chinmay09/ECEN_5009_Project_Lab/Patil_Schematic_20181208/Patil_Schematic01_20181208.pdf

# Revision History

REV ZONE | DESCRIPTION | DRFT | DATE | PCO/ECO

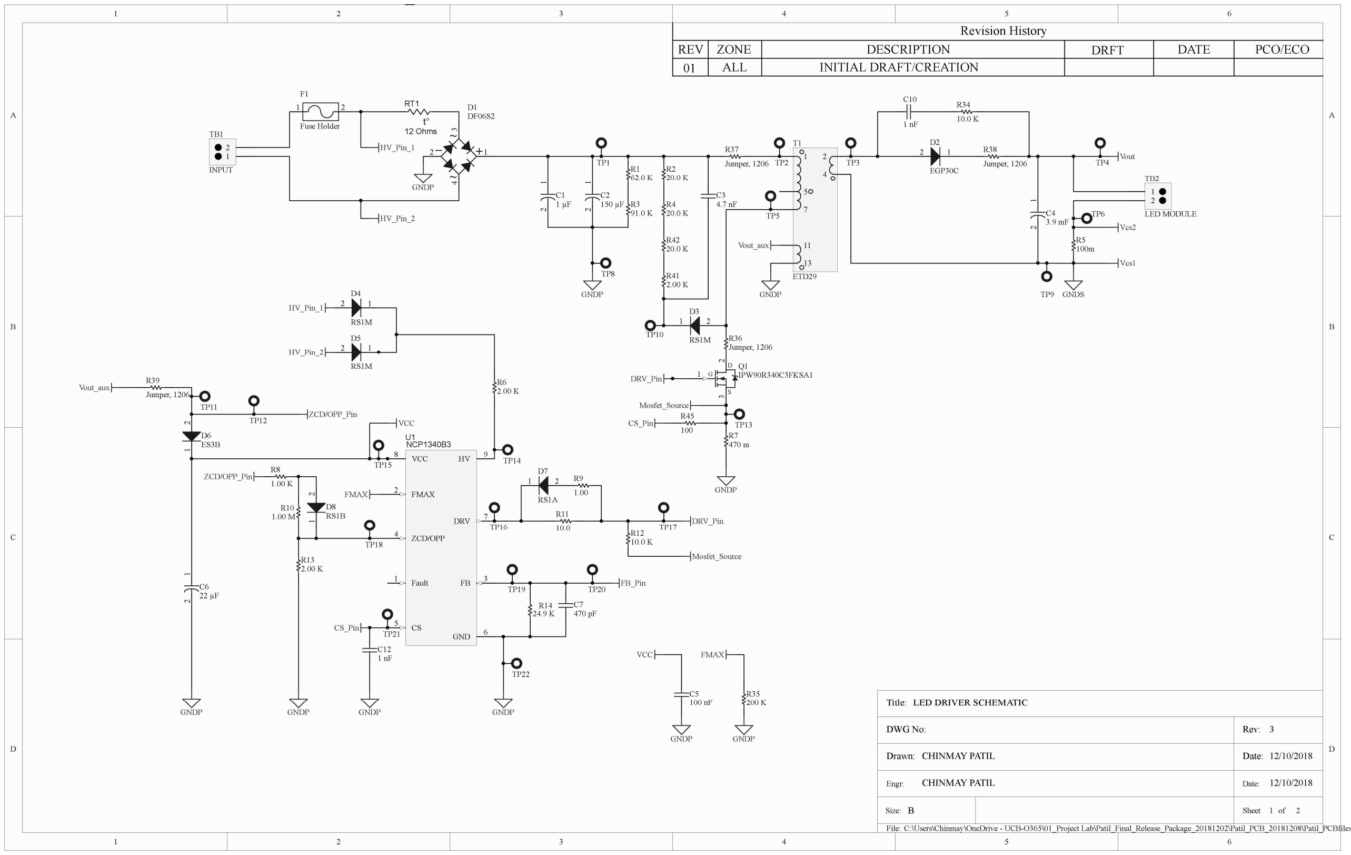
[picture p1: page 1]

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
## LED DRIVER SCHEMATIC

3

12/10/2018

C:\Users\Chinmay\OneDrive - UCB-O365\01_Project Lab\Patil_Final_Release_Package_20181202\Patil_PCB_20181208\Patil_PCBfiles_20181208\Patil_Sheet_1_20181208.SchDoc

## Title:

Size:

## DWG No:

## Date:

File:

## Rev:

B | Sheet | of

## Drawn:

Engr: | Date:
01 | ALL | INITIAL DRAFT/CREATION

## CHINMAY PATIL

CHINMAY PATIL | 12/10/2018

1

2

TB1

INPUT

1 2

F1

Fuse Holder | 3

1 4

2 +

_

~

~

D1
DF06S2

GNDP

C3

### 4.7 nF

GNDP

GNDP

2 1

D2

EGP30C

1
2

TB2

LED MODULE

Fault 1

FMAX 2

FB 3

ZCD/OPP 4

CS 5
GND | 6
DRV | 7
VCC 8 | HV | 9

U1
NCP1340B3

2 1

D5

RS1M

2 1

D4

RS1M

GNDP 1 2 D6

# ES3B 1 2

C6

### 22 µF

GNDP | GNDP | GNDP

R8

### 1.00 K

R13

### 2.00 K

1 2

D7

RS1A

R9
1.00

R11

### 10.0 R12

### 10.0 K

GNDS

R6

### 2.00 K

1 2
C1

### 1 µF

1 2

D3

RS1M

1 2
C2
150 µF

R1

### 62.0 K

R3

### 91.0 K

C5
100 nF

GNDP ¹ ² D8

RS1B

C10

### 1 nF

R34

### 10.0 K

GNDP

t°

RT1

### 12 Ohms

R7
470 m

R5

100m ¹ ²
C4

### 3.9 mF

R36
Jumper, 1206

R37
Jumper, 1206

R38
Jumper, 1206

R39

Jumper, 1206 | S D

G 2 3
1

Q1
IPW90R340C3FKSA1

R41

### 2.00 K

R2

### 20.0 K

R4

### 20.0 K

R42

### 20.0 K

1 2

4

5

7

11

13

T1

ETD29

Vout_aux

Vout_aux

ZCD/OPP_Pin

ZCD/OPP_Pin

VCC

VCC

FMAX

FMAX

CS_Pin

CS_Pin

Mosfet_Source

Mosfet_Source

DRV_Pin

DRV_Pin

FB_Pin

Vout

Vcs2

Vcs1

HV_Pin_1

HV_Pin_1

HV_Pin_2

HV_Pin_2

TP1 | TP2

TP5

TP10

TP8

TP3

TP14 TP15

TP12

TP11

TP18

TP16 | TP17
TP19 | TP20

TP22

TP21

TP13

TP6

TP4

TP9

R10

### 1.00 M

C7
470 pF

R14

### 24.9 K

R35
200 K
GNDP

R45
100

C12

### 1 nF
