chinmay09/ECEN_5009_Project_Lab/Patil_Schematic_20181208/Patil_Schematic02_20181208.pdf

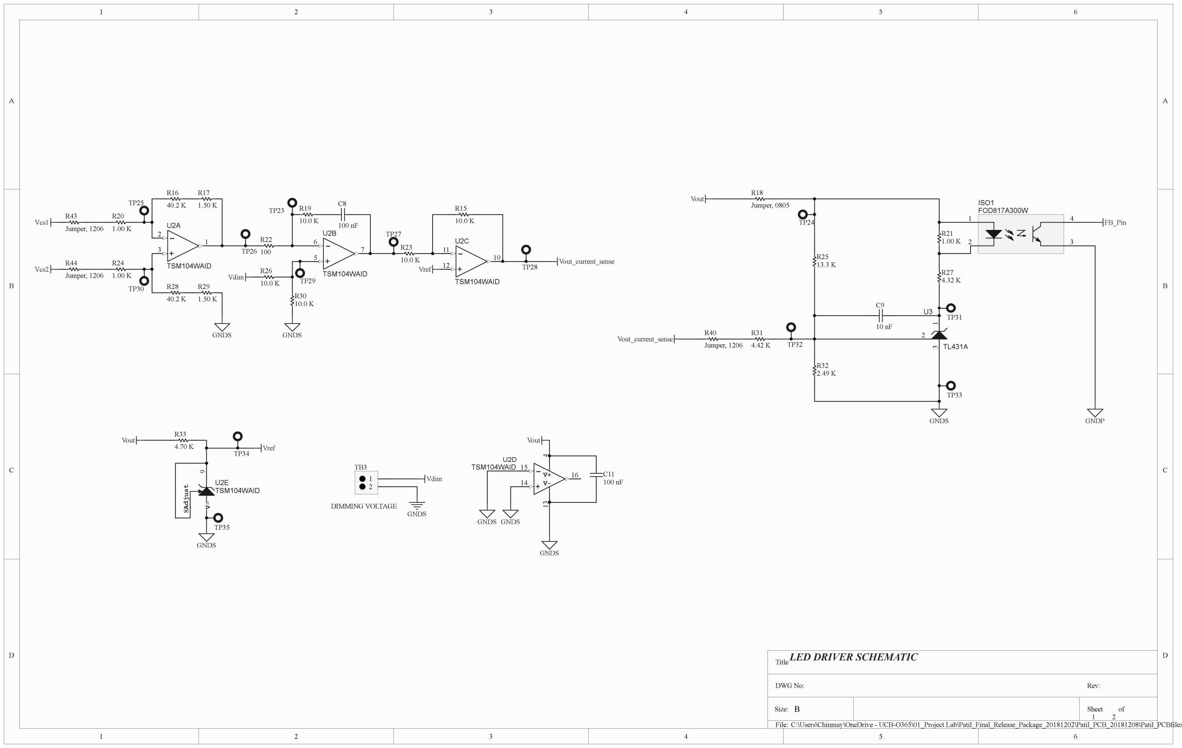
[picture p2: page 1]

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
## LED DRIVER SCHEMATIC

C:\Users\Chinmay\OneDrive - UCB-O365\01_Project Lab\Patil_Final_Release_Package_20181202\Patil_PCB_20181208\Patil_PCBfiles_20181208\Patil_Sheet_2_20181208.SchDoc

Title

Size:

DWG No:

File:

Rev:

B | Sheet | of

R24

### 1.00 K

R20

### 1.00 K

R16

### 40.2 K

R28

### 40.2 K

R17

### 1.50 K

R29

### 1.50 K

GNDS

R19

### 10.0 K

R26

### 10.0 K

R30

### 10.0 K

GNDS

GNDS

GNDS

2

1 4

3

ISO1
FOD817A300W

GNDP

1
2

TB3

DIMMING VOLTAGE

GNDS ⁹

8Adjust V-

U2E
TSM104WAID

GNDS

2 3 1

U3

TL431A

R23

### 10.0 K

R15

### 10.0 K

R33

### 4.70 K

GNDS GNDS

R18
Jumper, 0805

R32

### 2.49 K

14

15

16 13 4 +
- V+
V-

U2D
TSM104WAID

12

11
10
+

U2C

TSM104WAID

5

6
7
+

U2B

TSM104WAID

3

2
1
+

U2A

TSM104WAID

C11
100 nF

R40
Jumper, 1206

R43
Jumper, 1206

R44
Jumper, 1206

Vcs1

Vcs2
Vdim

Vref

Vout_current_sense

Vout_current_sense

Vout

FB_Pin

Vout | Vout

Vdim

Vref

TP28

TP27

TP23

TP26

TP29

TP25

TP30

TP34

TP35

TP24

TP31

TP32

TP33

R22
100

C8

100 nF
R21

### 1.00 K

R27

### 4.32 K

C9

### 10 nF

R25

### 13.3 K

R31

### 4.42 K
