chinmay09/ECEN_5009_Project_Lab/Patil_Calculations_20181208/Patil_Calculations_20181208-DESKTOP-5JLHRRT.pdf

# ECEN 5009 Power Electronics Project Lab

Prepared By: | CHINMAY PATIL
Project: | LED Driver
Last Updated: | 8-Dec-2018
Description: | PROJECT CALCULATIONS
Revision: | 4

## General Calculations

## Vac

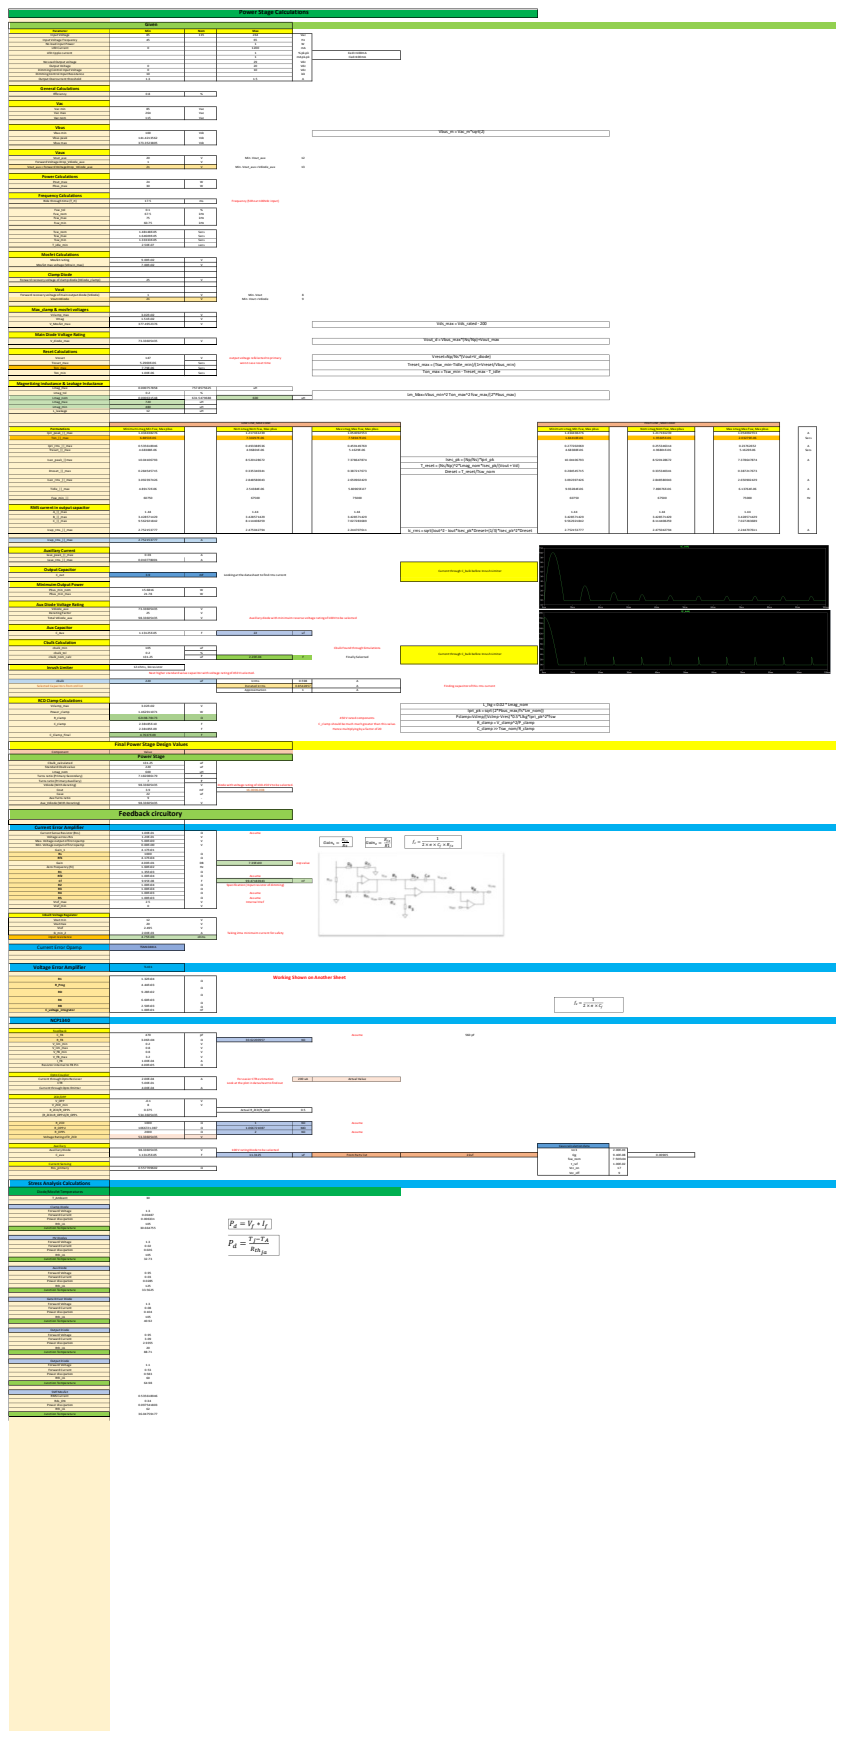
[picture p3: page 2]
Parameter; Min; Nom; Max; Input Voltage; Vac; Input Voltage Frequency; No load input Power; LED Current; LED ripple current; Iled>=100mA; Iled<100mA; No Load Output voltage; Vdc; Output Voltage; Dimming Control Input Voltage; Dimming Control Input Resistance; Output Overcurrent threshold; Efficiency; Vac min; Vac max; Vac nom; Vbus; Vbus min; Vbus peak; Vbus max; Vaux; Vout_aux; Min. Vout_aux; Forward Voltage Drop_Vdiode_aux; Vout_aux + Forward VoltageDrop_ Vdiode_aux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

Power Stage Calculations

V_Mosfet_max 377.4952376 | V

Main Diode Voltage Rating

Vreset=Np/Ns*(Vout+V_diode)

Magnetizing inductance & Leakage Inductance

T_reset = (Ns/Np)^2*Lmag_nom*Isec_pk/(Vout + Vd)

RMS current in output capacitor

Minimuim Output Power

Aux Diode Voltage Rating

Current through C_bulk before Inrush Limiter

Next higher standard value capacitor with voltage rating of 450 V selected.

RCD Clamp Calculations

Vclamp_max Power_clamp | 3.02E+02 1.462911071 | V W

Pclamp=Vclmp/(Vclmp-Vres)*0.5*Llkg*Ipri_pk^2*fsw

Final Power Stage Design Values

Current Error Amplifier

Inbuilt Voltage Regulator

Working Shown on Another Sheet

Voltage Rating of D_ZCD | 53.33605435 | V

Stress Analysis Calculations
Diode/Mosfet Temperatures

Gate Driver Diode

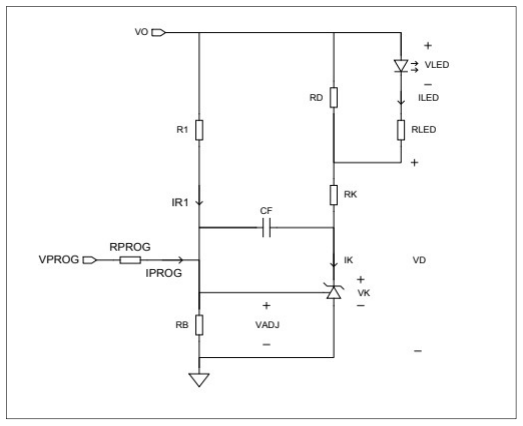
[picture p4: figure]

Vout_min | 10 | V
Vout_max | 21 | V
Vadj | 2.495 | V
I_BIAS | 1.00E-03 | A
Vprog_min | 0.7 | V
Vprog_max | 4.406 | V
Vk | 2.5 | V
V_diode_opto | 0.9 | V
V_acrossRK | 6.6 | V
Ik_min | 1.00E-03 | A
Ie_min | 1.00E-03 | A
I_opto_min | 3.00E-05 | A
I_opto_max | 4.00E-04 | A
Id_min | 6.00E-04 | A
Id_max | 9.70E-04 | A
A11 | 7.505 | V
A12 | 1.911 | V
A21 | 18.505 | V
A22 | -1.795 | V
A | 7.505 | 1.911
18.505 -1.795
A^-1 | 0.03675678 0.039132
0.37893269 -0.15368
I_BIAS | 1.00E-03
| 1.00E-03
G1 | = | A^-1 | X | I_BIAS
G1 | 7.5889E-05 | GPROG | I_BIAS
GPROG | 2.25E-04
R1 | 1.32E+04 | Ω
RPROG | 4.44E+03 | Ω
RD | 9.28E+02 | Ω
RK | 6.60E+03 | Ω
RB | 2.50E+03 | Ω
Cf | 10 | nF | Fz | 166 | Hz

# TL431 Calculations

# Fz = 1/(2∏Cf)

# A11 = Vout_min - Vadj A12 = Vprog_max - Vadj A21 = Vout_max - Vadj A22 = Vprog_min - Vadj

# Formula

# RK = V_acrossRK/Ik_min

# RB = Vadj/Ibias

# RD = V_diode/Id_max

DATA INPUT | RESULTS
Vbus_min | 100 | Vbus_min | 100
Peak output power (Wpk) | 24 | Peak pri current = | 1.2 | V_out | 20 | V_out | 20
I_out | 1.2 | I_out | 5.00E-03
Min dc input voltage (on Cbulk) | 100 | Primary rms current = | 0.562849891 | Output Load | 16.66666667 | Output Load | 4000
Fsw_nom | 67500 | Fsw_nom | 67500
Efficiency estimate (dec. #) | 0.8 | Primary L (uH) = | 617.2839506 | Tsw_nom | 1.48148E-05 | Tsw_nom | 1.48148E-05
Np/Ns | 7.182086179 | ~ | 7 | Np/Na | 7 | ~ | 7
Switching freq (kHz) | 67.5 | Primary turns = | 38.98635478 | Dmax | 0.387217673 | Dmax | 0.387217673
(set to 45 kHz for QR design) | Ipri_peak | 1.434438276 | Ipri_peak | 1.434438276
Min secondary turns = | 4.016775947
Core area (Ae in sq cm) | 0.76
ρ | 1.72E-06 | 2.30E-06 | ρ | 1.72E-06
Max core flux (kilogauss) | 2.5 | Approx core gap-inches = | 0.01122807 | Bmax | 0.25 | Bmax | 0.25
P_Cu | 1 | P_Cu | 1
Output voltage | 20 | Ku | 0.5 | Ku | 0.5
µ0 | 1.25664E-06 | A | µ0 | 1.25664E-05
Duty Cycle max. | 0.66 | Np | 28 | Approximated | Np | 49 | Approximated
(set to 0.6 for QR design) | Ns | 4 | Approximated | Na | 7 | Approximated
= Enter Data | = Calculated Data
Imag | 1.434438276 | A | Imag | 1.434438276
Delta_Imag | 1.434438276 | A | Delta_Imag | 1.434438276
Lmag | 617.2839506 | uH | 6.00E-04 | Lmag | 617.2839506 | 6.00E-04
I_primary | 0.535618946 | | | I_primary | 0.535618946
I_secondary | 3.092397426 | | | I_aux | 0.010778001
I_tot | 0.978929721 | | | I_tot | 0.978929721
| | Kg | 0.193 | | | Kg | 0.193
Core Geometry | | Ac | 0.97 | Core Geometry | | Ac | 0.97
kg | 0.003907038 | WA | 1.23 | kg | 0.003907038 | WA | 1.23
| | MLT | 6 | | | MLT | 6
| | lm | 7.86 | | | lm | 7.86
Air Gap Length | | | | Air Gap Length
lg | 0.000255902 | | | lg | 0.002559017
Fill Areas | | | | Fill Areas
α1 | 0.547147496 | | | α1 | 0.547147496
α2 | 0.451279649 | | | α2 | 0.001572855
ratio | 2 | | 2 | Lecture
delta_25 | 0.254057762 | mm | 0.293786722 | delta_100
| 0.01000228 | in | 0.011566413
AWG | 24.04137605 | | 22.78824267
AWG_min | 24 | | 22
AWG_max | 25 | | 23 | Lecture
Current Density | 400 | | Primary RMS current | 0.535
Wire Area | 2.63E-03 | | Secondary RMS current | 3.02
Wire Current Capacity | 1.05E+00 | | Auxiliary RMS current | 1.00E-02
Primary | 0.51 | = | 1
Secondary | 2.88 | = | 3
Auxiliary | 0.01 | = | 1
Primary | 0.12
Secondary | 0.05
Auxiliary | 0.02
AirGap Length (Each Side) | 0.005614035 | blue Uh uH
Magnetizing Inductance | 547 | | Secondary Magnetizing Inductance | 14.342 | uH
Leakage Inductance | 5 | | Auxilliary Magnetizing Inductance | 14.504 | uH
AirGap Length (Each Side) | 0.004 | tan uH uH
Magnetizing Inductance | 628.53
Leakage Inductance | 5.477

## Polarity Testing

Primary Winding Voltage Secondary Winding Voltage Auxillary Winding Voltage | 266 39.2 39.2 | mV mV mV | Function generator voltage 1.41 V, 67 kHz
Turns Ratio (PandS) | 6.785714286
Turns Ratio (PandA) | 6.785714286

# XFMR DESIGN

# Given

## ETD34 CORE

# Primary:Auxillary

# Given

FLYBACK XFMR DESIGN | XFMR DESIGN | Primary:Secondary

# Calculation

# Wire Current Capacity = Current Density * Wire Area

# Number of Strands = RMS Current/Wire Current Capacity

# Calculation

## ETD34 CORE

# Test Conditions Main Calculation

# AWG

# Strands

# Fill Area

## Transformer Testing

I = I_

## Δi = I

L =

## VDT 2∆i

I = I__

I = I__

I = I +
(I

)+
(I) K ≥

ρ L

I
I_

B

P K

l =

μ

L I_

B

A

I = I__ | A_ =
α K W N | A_ =

## α K W N A_ =

## α K W N

Bleeder Resistance | Calculator
ENTER: Capacitor Value (uF) | 150

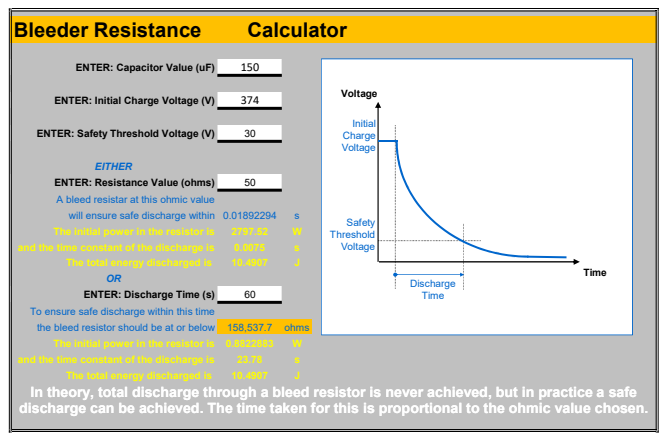
[picture p5: page 5]
ENTER: Initial Charge Voltage (V); ENTER: Safety Threshold Voltage (V); EITHER; ENTER: Resistance Value (ohms); will ensure safe discharge within 0.01892294; The initial power in the resistor is; and the time constant of the discharge is; The total energy discharged is; ENTER: Discharge Time (s); The initial power in the resistor is 0.8822883; Voltage; Time; Initial Charge Voltage; Discharge Time; Safety Threshold Voltage

A bleed resistar at this ohmic value

To ensure safe discharge within this time
the bleed resistor should be at or below 158,537.7 ohms

In theory, total discharge through a bleed resistor is never achieved, but in practice a safe
discharge can be achieved. The time taken for this is proportional to the ohmic value chosen.
