chinmay09/ECEN_5009_Project_Lab/Patil_Transformer_20181208/Patil_Transformer Layout_20181102.pdf

## Title: Transformer Layout

## Name: Chinmay Patil

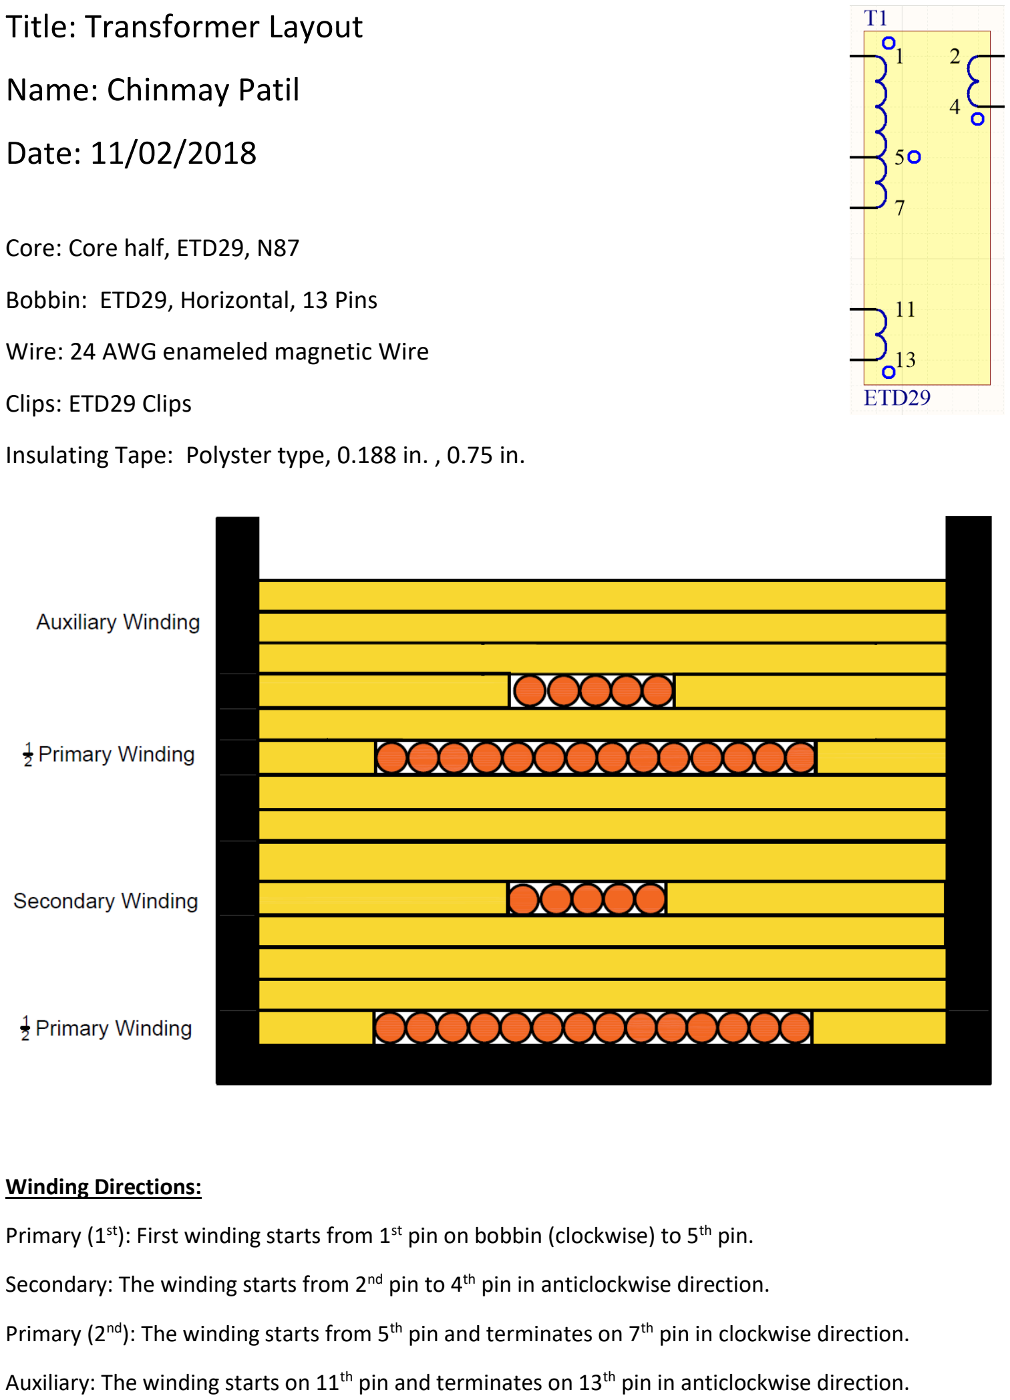
[picture p6: page 1]

## Date: 11/02/2018

Core: Core half, ETD29, N87

Bobbin: ETD29, Horizontal, 13 Pins

Wire: 24 AWG enameled magnetic Wire

Clips: ETD29 Clips

Insulating Tape: Polyster type, 0.188 in. , 0.75 in.

Winding Directions:

Primary (1st): First winding starts from 1st pin on bobbin (clockwise) to 5th pin.

Secondary: The winding starts from 2nd pin to 4th pin in anticlockwise direction.

Primary (2nd): The winding starts from 5th pin and terminates on 7th pin in clockwise direction.

Auxiliary: The winding starts on 11th pin and terminates on 13th pin in anticlockwise direction.
