chinmay09/ECEN_5009_Project_Lab/Patil_Parts_List_20181208/Patil_Parts_List_20181208.xlsx

Sheet: Project Information
ECEN 5009 Power Electronics Project Lab
Prepared By: | Chinmay Patil
Project: | LED Driver
Last Updated: | 2018-11-30
Description: | Parts List

Sheet: Top Level BOM
Top Level Assembly Bill Of Materials
Note: | For indeterminate or variable quantities, such as the amount of margin tape, use "A/R" (stands for "As Required") for the quantity
Note: | One possible use of the "Note/Comment" field is to record the function of the component
Item Number | Part Number | Description | Quantity | Reference Designators | Note/Comment
1 | 19-0002-003 | Screw, Pan Head, Phillips, #6-32, 0.5 inch, Stainless | 4 |  | Stand
2 | 19-0005-002 | Washer, Flat, #6, Stainless | 4
3 | 19-0006-002 | Washer, Split Lock, #6, Stainless | 4
4 | 19-0007-003 | Spacer, Hex, Threaded, #6-32, 0.5 inch, Aluminum | 4
5 | 18-0015-005 | Printed Circuit Board, LED Driver, Fall 2018, Patil | 1 |  | PCB

Sheet: PCB Assembly Parts List
PCB Assembly Parts List
Note: | Order status shall be one of the following: "Not ordered", "Ordered DD MMM YYYY", "Received"
Note: | One possible use of the "Note/Comment" field is to record the circuit function of the component
Designator | Comment | Description | Distributor | Distributor Part Number | Footprint | LibRef | Manufacturer Part Number | Package | Quantity | Rated Power (W) | Value
C1 | 1 µF | Capacitor, Film, 1 µF, ±5%, 450 V, Metallized Polypropylene, Radial, Lead | Digi-Key | PCF1616-ND | CAP-RAD-THRU-L17.5 X W7.8 X LS15.0 X H11.0MM | 16-0009-002 | ECW-FD2W105J | Radial, Lead | 1 |  | 1 µF
C2 | 150 µF | Capacitor, Al. El., 150 µF, ±20%, 450 V, Radial, Snap | Digi-Key | 493-17561-ND | CAP-SNAP_D25 X H35MM_A35 | 16-0003-003 | LKX2W151MESA35 | Radial, Snap | 1 |  | 150 µF
C3 | 4.7 nF | Capacitor, Ceramic, 4.7 nF, ±10%, 1000 V, X7R, 1210 | Digi-Key | 720-1057-1-ND | CAP-1210M_IPC | 16-0010-003 | VJ1210Y472KXGAT5Z | 1210 | 1 |  | 4.7 nF
C4 | 3.9 mF | Capacitor, Al. El., 3.9 mF, ±20%, 35 V, Radial, Lead | Digi-Key | 493-1602-ND | CAP-RAD-THRU-D18.0 X LS7.5 X H40.0MM | 16-0006-007 | UHE1V392MHD | Radial, Lead | 1 |  | 3.9 mF
C5 | 100 nF | Capacitor, Ceramic, 100 nF, ±10%, 50 V, X7R, 0805 | Lab Stock | 16-0001-066 | CAP-0805M_IPC | 16-0001-066 | C2012X7R1H104KT | 0805 | 1 |  | 100 nF
C6 | 22 µF | Capacitor, Al. El., 22 µF, ±20%, 35 V, SMT | Digi-Key | PCE4025CT-ND | CAPAE660X540M_CASE-D_IPC | 16-0005-007 | EEEFC1V220P | SMT | 1 |  | 22 µF
C7 | 470 pF | Capacitor, Ceramic, 470 pF, ±5%, 50 V, NP0, 0805 | Lab Stock | 16-0001-038 | CAP-0805M_IPC | 16-0001-038 | C2012C0G1H471JT | 0805 | 1 |  | 470 pF
C8 | 100 nF | Capacitor, Ceramic, 100 nF, ±10%, 50 V, X7R, 1206 | Lab Stock | 16-0002-059 | CAP-1206M_IPC | 16-0002-059 | C3216X7R1H104KT | 1206 | 1 |  | 100 nF
C9 | 10 nF | Capacitor, Ceramic, 10 nF, ±10%, 50 V, X7R, 0805 | Lab Stock | 16-0001-054 | CAP-0805M_IPC | 16-0001-054 | C2012X7R1H103KT | 0805 | 1 |  | 10 nF
C10 | 1 nF | Capacitor, Ceramic, 1 nF, ±10%, 1000 V, X7R, 1210 | Digi-Key | 720-1045-1-ND | CAP-1210M_IPC | 16-0010-001 | VJ1210Y102KXGAT5Z | 1210 | 1 |  | 1 nF
C11 | 100 nF | Capacitor, Ceramic, 100 nF, ±10%, 50 V, X7R, 1206 | Lab Stock | 16-0002-059 | CAP-1206M_IPC | 16-0002-059 | C3216X7R1H104KT | 1206 | 1 |  | 100 nF
C12 | 1 nF | Capacitor, Ceramic, 1 nF, ±10%, 50 V, X7R, 0805 | Lab Stock | 16-0001-042 | CAP-0805M_IPC | 16-0001-042 | C2012COG1H102JT | 0805 | 1 |  | 1 nF
D1 | DF06S2 | Diode, Bridge, Std Recovery, DF06S2, 600 V, 2 A, SDIP-4 | Digi-Key | DF06S2CT-ND | SOIC510P1040X260-4M_IPC | 13-0015-001 | DF06S2 | SDIP-4 | 1
D2 | EGP30C | Diode, Fast Recovery, EGP30C, 150 V, 3 A, DO-201AD | Digi-Key | EGP30CCT-ND | DIO-AXIAL-DO-201AD | 13-0023-001 | EGP30C | DO-201AD, Axial | 1
D3 | RS1M | Diode, Fast Recovery, RS1M, 1000 V, 1 A, SMA | Digi-Key | RS1MFSCT-ND | DIODE-SMA-DO214AC | 13-0001-007 | RS1M | SMA | 1
D4 | RS1M | Diode, Fast Recovery, RS1M, 1000 V, 1 A, SMA | Digi-Key | RS1MFSCT-ND | DIODE-SMA-DO214AC | 13-0001-007 | RS1M | SMA | 1
D5 | RS1M | Diode, Fast Recovery, RS1M, 1000 V, 1 A, SMA | Digi-Key | RS1MFSCT-ND | DIODE-SMA-DO214AC | 13-0001-007 | RS1M | SMA | 1
D6 | ES3B | Diode, Fast Recovery, ES3B, 100 V, 3 A, SMC | Digi-Key | ES3BFSCT-ND | DIODE-SMC-DO214AB | 13-0026-002 | ES3B | SMC | 1
D7 | RS1A | Diode, Fast Recovery, RS1A, 50 V, 1 A, SMA | Digi-Key | RS1ACT-ND | DIODE-SMA-DO214AC | 13-0001-001 | RS1A | SMA | 1
D8 | RS1B | Diode, Fast Recovery, RS1B, 100 V, 1 A, SMA | Digi-Key | RS1BFSCT-ND | DIODE-SMA-DO214AC | 13-0001-002 | RS1B | SMA | 1
F1 | Fuse Holder | Fuse Holder, TH, 5mm, 3AG | Digi-Key | 36-4527-ND | FUSE_HOLDER_3AG_4527 | 18-0012-001 | 4527 | TH | 1
ISO1 | FOD817A300W | Opto-coupler, FOD817A300W, DIP, Wide Lead | Digi-Key | FOD817A300W-ND | DIP1016W7P254L51H57Q4A_IPC | 14-0002-002 | FOD817A300W | DIP, Wide Lead | 1
Q1 | IPW90R340C3FKSA1 | MOSFET, N-Channel, IPW90R340C3FKSA1, 900 V, 340 mOhm, TO-247 | Digi-Key | IPW90R340C3FKSA1-ND | TO546P508X1588X2483-3A_IPC | 10-0016-002 |  | TO-247 | 1
R1 | 62.0 K | Resistor, TH, 62.0 K, 5%, 2 W, MO, Axial | Digi-Key | 62KW-2-ND | RES-AXIAL-2W_IPC | 15-0005-124 | RSF200JB-73-62K | Axial | 1 | 2 W | 62.0 K
R2 | 20.0 K | Resistor, SMT, 20.0 K, 5%, 1 W, 2512 | Lab Stock | 15-0004-129 | RES-2512M_IPC | 15-0004-129 |  | 2512 | 1 | 1 W | 20.0 K
R3 | 91.0 K | Resistor, TH, 91.0 K, 5%, 2 W, MO, Axial | Digi-Key | 91KW-2-ND | RES-AXIAL-2W_IPC | 15-0005-128 | RSF200JB-73-91K | Axial | 1 | 2 W | 91.0 K
R4 | 20.0 K | Resistor, SMT, 20.0 K, 5%, 1 W, 2512 | Lab Stock | 15-0004-129 | RES-2512M_IPC | 15-0004-129 |  | 2512 | 1 | 1 W | 20.0 K
R5 | 100m | Resistor, SMT, 100m, 1%, 1 W, 2512 | Digi-Key | 311-0.1TCT-ND | RES-2512M_IPC | 15-0012-001 | RL2512FK-070R1L | 2512 | 1 | 1 W | 100m
R6 | 2.00 K | Resistor, TH, 2.00 K, 5%, 2 W, MO, Axial | Digi-Key | 2.0KW-2-ND | RES-AXIAL-2W_IPC | 15-0005-088 | RSF200JB-73-2K | Axial | 1 | 2 W | 2.00 K
R7 | 470 m | Resistor, SMT, 470 m, 1%, 1 W, 2512 | Digi-Key | 311-0.47TCT-ND | RES-2512M_IPC | 15-0012-003 | RL2512FK-070R47L | 2512 | 1 | 1 W | 470 m
R8 | 1.00 K | Resistor, SMT, 1.00 K, 5%, 1 W, 2512 | Lab Stock | 15-0004-098 | RES-2512M_IPC | 15-0004-098 |  | 2512 | 1 | 1 W | 1.00 K
R9 | 1.00 | Resistor, SMT, 1.00, 1%, 125 mW, 0805 | Lab Stock | 15-0002-001 | RES-0805M_IPC | 15-0002-001 |  | 0805 | 1 | 125 mW | 1.00
R10 | 1.00 M | Resistor, SMT, 1.00 M, 1%, 250 mW, 1206 | Lab Stock | 15-0003-577 | RES-1206M_IPC | 15-0003-577 |  | 1206 | 1 | 250 mW | 1.00 M
R11 | 10.0 | Resistor, SMT, 10.0, 1%, 125 mW, 0805 | Lab Stock | 15-0002-097 | RES-0805M_IPC | 15-0002-097 |  | 0805 | 1 | 125 mW | 10.0
R12 | 10.0 K | Resistor, SMT, 10.0 K, 1%, 250 mW, 1206 | Lab Stock | 15-0003-385 | RES-1206M_IPC | 15-0003-385 |  | 1206 | 1 | 250 mW | 10.0 K
R13 | 2.00 K | Resistor, SMT, 2.00 K, 5%, 1 W, 2512 | Lab Stock | 15-0004-105 | RES-2512M_IPC | 15-0004-105 |  | 2512 | 1 | 1 W | 2.00 K
R14 | 24.9 K | Resistor, SMT, 24.9 K, 1%, 250 mW, 1206 | Lab Stock | 15-0003-423 | RES-1206M_IPC | 15-0003-423 |  | 1206 | 1 | 250 mW | 24.9 K
R15 | 10.0 K | Resistor, SMT, 10.0 K, 1%, 250 mW, 1206 | Lab Stock | 15-0003-385 | RES-1206M_IPC | 15-0003-385 |  | 1206 | 1 | 250 mW | 10.0 K
R16 | 40.2 K | Resistor, SMT, 40.2 K, 1%, 250 mW, 1206 | Lab Stock | 15-0003-443 | RES-1206M_IPC | 15-0003-443 |  | 1206 | 1 | 250 mW | 40.2 K
R17 | 1.50 K | Resistor, SMT, 1.50 K, 1%, 250 mW, 1206 | Lab Stock | 15-0003-306 | RES-1206M_IPC | 15-0003-306 |  | 1206 | 1 | 250 mW | 1.50 K
R18 | Jumper, 0805 | Jumper, 0805 |  |  | RES-0805M_IPC | 15-0001-001 |  | 0805 | 1
R19 | 10.0 K | Resistor, SMT, 10.0 K, 1%, 250 mW, 1206 | Lab Stock | 15-0003-385 | RES-1206M_IPC | 15-0003-385 |  | 1206 | 1 | 250 mW | 10.0 K
R20 | 1.00 K | Resistor, SMT, 1.00 K, 1%, 250 mW, 1206 | Lab Stock | 15-0003-289 | RES-1206M_IPC | 15-0003-289 |  | 1206 | 1 | 250 mW | 1.00 K
R21 | 1.00 K | Resistor, SMT, 1.00 K, 1%, 125 mW, 0805 | Lab Stock | 15-0002-289 | RES-0805M_IPC | 15-0002-289 |  | 0805 | 1 | 125 mW | 1.00 K
R22 | 100 | Resistor, SMT, 100, 1%, 250 mW, 1206 | Lab Stock | 15-0003-193 | RES-1206M_IPC | 15-0003-193 |  | 1206 | 1 | 250 mW | 100
R23 | 10.0 K | Resistor, SMT, 10.0 K, 1%, 250 mW, 1206 | Lab Stock | 15-0003-385 | RES-1206M_IPC | 15-0003-385 |  | 1206 | 1 | 250 mW | 10.0 K
R24 | 1.00 K | Resistor, SMT, 1.00 K, 1%, 250 mW, 1206 | Lab Stock | 15-0003-289 | RES-1206M_IPC | 15-0003-289 |  | 1206 | 1 | 250 mW | 1.00 K
R25 | 13.3 K | Resistor, TH, 13.3 K, 1%, 250 mW, MF, Axial | Digi-Key | 13.3KXBK-ND | RES-AXIAL-250mW_IPC | 15-0007-397 | MFR-25FBF52-13K3 | Axial | 1 | 250 mW | 13.3 K
R26 | 10.0 K | Resistor, SMT, 10.0 K, 1%, 250 mW, 1206 | Lab Stock | 15-0003-385 | RES-1206M_IPC | 15-0003-385 |  | 1206 | 1 | 250 mW | 10.0 K
R27 | 4.32 K | Resistor, SMT, 4.32 K, 1%, 250 mW, 1206 | Lab Stock | 15-0003-350 | RES-1206M_IPC | 15-0003-350 |  | 1206 | 1 | 250 mW | 4.32 K
R28 | 40.2 K | Resistor, SMT, 40.2 K, 1%, 250 mW, 1206 | Lab Stock | 15-0003-443 | RES-1206M_IPC | 15-0003-443 |  | 1206 | 1 | 250 mW | 40.2 K
R29 | 1.50 K | Resistor, SMT, 1.50 K, 1%, 250 mW, 1206 | Lab Stock | 15-0003-306 | RES-1206M_IPC | 15-0003-306 |  | 1206 | 1 | 250 mW | 1.50 K
R30 | 10.0 K | Resistor, SMT, 10.0 K, 1%, 250 mW, 1206 | Lab Stock | 15-0003-385 | RES-1206M_IPC | 15-0003-385 |  | 1206 | 1 | 250 mW | 10.0 K
R31 | 4.42 K | Resistor, TH, 4.42 K, 1%, 250 mW, MF, Axial | Digi-Key | 4.42KXBK-ND | RES-AXIAL-250mW_IPC | 15-0007-351 | MFR-25FBF52-4K42 | Axial | 1 | 250 mW | 4.42 K
R32 | 2.49 K | Resistor, SMT, 2.49 K, 1%, 250 mW, 1206 | Lab Stock | 15-0003-327 | RES-1206M_IPC | 15-0003-327 |  | 1206 | 1 | 250 mW | 2.49 K
R33 | 4.70 K | Resistor, SMT, 4.70 K, 5%, 1 W, 2512 | Lab Stock | 15-0004-114 | RES-2512M_IPC | 15-0004-114 |  | 2512 | 1 | 1 W | 4.70 K
R34 | 10.0 K | Resistor, SMT, 10.0 K, 5%, 1 W, 2512 | Lab Stock | 15-0004-122 | RES-2512M_IPC | 15-0004-122 |  | 2512 | 1 | 1 W | 10.0 K
R35 | 200 K | Resistor, SMT, 200 K, 1%, 250 mW, 1206 | Lab Stock | 15-0003-510 | RES-1206M_IPC | 15-0003-510 |  | 1206 | 1 | 250 mW | 200 K
R36 | Jumper, 1206 | Jumper, 1206 |  |  | RES-1206M_IPC | 15-0001-002 |  | 0805 | 1
R37 | Jumper, 1206 | Jumper, 1206 |  |  | RES-1206M_IPC | 15-0001-002 |  | 0805 | 1
R38 | Jumper, 1206 | Jumper, 1206 |  |  | RES-1206M_IPC | 15-0001-002 |  | 0805 | 1
R39 | Jumper, 1206 | Jumper, 1206 |  |  | RES-1206M_IPC | 15-0001-002 |  | 0805 | 1
R40 | Jumper, 1206 | Jumper, 1206 |  |  | RES-1206M_IPC | 15-0001-002 |  | 0805 | 1
R41 | 2.00 K | Resistor, SMT, 2.00 K, 5%, 1 W, 2512 | Lab Stock | 15-0004-105 | RES-2512M_IPC | 15-0004-105 |  | 2512 | 1 | 1 W | 2.00 K
R42 | 20.0 K | Resistor, SMT, 20.0 K, 5%, 1 W, 2512 | Lab Stock | 15-0004-129 | RES-2512M_IPC | 15-0004-129 |  | 2512 | 1 | 1 W | 20.0 K
R43 | Jumper, 1206 | Jumper, 1206 |  |  | RES-1206M_IPC | 15-0001-002 |  | 0805 | 1
R44 | Jumper, 1206 | Jumper, 1206 |  |  | RES-1206M_IPC | 15-0001-002 |  | 0805 | 1
R45 | 100 | Resistor, SMT, 100, 1%, 125 mW, 0805 | Lab Stock | 15-0002-193 | RES-0805M_IPC | 15-0002-193 |  | 0805 | 1 | 125 mW | 100
RT1 | 12 Ohms | Inrush Limiter, 12 Ohms, ±20%, 3 A, 15.5 mm, Radial | Digi-Key | 317-1200-ND | THERM-RADIAL-15.5MM_DIA_X6MM_THK | 15-0010-003 | MF72-012D13 | Radial | 1 | 3 A | 12 Ohms
T1 | ETD29 | Bobbin, ETD29, Horzontal, 13 Pins | Digi-Key | 495-5455-ND | TRANS508P3530X3520X2500-13A_IPC | 17-0002-002 | B66359X1014T001 | ETD29 | 1
TB1 | INPUT | Terminal Block, 2 Pos., Vertical, 14-30 AWG, 5.08 mm | Digi-Key | 277-1247-ND | CONN_2-POS_TERMINAL_BLOCK_1729128 | 18-0008-001 | 1729128 | 2 Pos. | 1
TB2 | LED MODULE | Terminal Block, 2 Pos., Vertical, 14-30 AWG, 5.08 mm | Digi-Key | 277-1247-ND | CONN_2-POS_TERMINAL_BLOCK_1729128 | 18-0008-001 | 1729128 | 2 Pos. | 1
TB3 | DIMMING VOLTAGE | Terminal Block, 2 Pos., Vertical, 14-30 AWG, 5.08 mm | Digi-Key | 277-1247-ND | CONN_2-POS_TERMINAL_BLOCK_1729128 | 18-0008-001 | 1729128 | 2 Pos. | 1
TP1 | Test Point | Test Point, SMT, Miniature | Digi-Key | 36-5019CT-ND | TP_SMT_LOOP-5019_3D | 18-0011-002 | 5019 | SMT | 1
TP2 | Test Point | Test Point, SMT, Miniature | Digi-Key | 36-5019CT-ND | TP_SMT_LOOP-5019_3D | 18-0011-002 | 5019 | SMT | 1
TP3 | Test Point | Test Point, SMT, Miniature | Digi-Key | 36-5019CT-ND | TP_SMT_LOOP-5019_3D | 18-0011-002 | 5019 | SMT | 1
TP4 | Test Point | Test Point, SMT, Miniature | Digi-Key | 36-5019CT-ND | TP_SMT_LOOP-5019_3D | 18-0011-002 | 5019 | SMT | 1
TP5 | Test Point | Test Point, SMT, Miniature | Digi-Key | 36-5019CT-ND | TP_SMT_LOOP-5019_3D | 18-0011-002 | 5019 | SMT | 1
TP6 | Test Point | Test Point, SMT, Miniature | Digi-Key | 36-5019CT-ND | TP_SMT_LOOP-5019_3D | 18-0011-002 | 5019 | SMT | 1
TP8 | Test Point | Test Point, SMT, Miniature | Digi-Key | 36-5019CT-ND | TP_SMT_LOOP-5019_3D | 18-0011-002 | 5019 | SMT | 1
TP9 | Test Point | Test Point, SMT, Miniature | Digi-Key | 36-5019CT-ND | TP_SMT_LOOP-5019_3D | 18-0011-002 | 5019 | SMT | 1
TP10 | Test Point | Test Point, SMT, Miniature | Digi-Key | 36-5019CT-ND | TP_SMT_LOOP-5019_3D | 18-0011-002 | 5019 | SMT | 1
TP11 | Test Point | Test Point, SMT, Miniature | Digi-Key | 36-5019CT-ND | TP_SMT_LOOP-5019_3D | 18-0011-002 | 5019 | SMT | 1
TP12 | Test Point | Test Point, SMT, Miniature | Digi-Key | 36-5019CT-ND | TP_SMT_LOOP-5019_3D | 18-0011-002 | 5019 | SMT | 1
TP13 | Test Point | Test Point, SMT, Miniature | Digi-Key | 36-5019CT-ND | TP_SMT_LOOP-5019_3D | 18-0011-002 | 5019 | SMT | 1
TP14 | Test Point | Test Point, SMT, Miniature | Digi-Key | 36-5019CT-ND | TP_SMT_LOOP-5019_3D | 18-0011-002 | 5019 | SMT | 1
TP15 | Test Point | Test Point, SMT, Miniature | Digi-Key | 36-5019CT-ND | TP_SMT_LOOP-5019_3D | 18-0011-002 | 5019 | SMT | 1
TP16 | Test Point | Test Point, SMT, Miniature | Digi-Key | 36-5019CT-ND | TP_SMT_LOOP-5019_3D | 18-0011-002 | 5019 | SMT | 1
TP17 | Test Point | Test Point, SMT, Miniature | Digi-Key | 36-5019CT-ND | TP_SMT_LOOP-5019_3D | 18-0011-002 | 5019 | SMT | 1
TP18 | Test Point | Test Point, SMT, Miniature | Digi-Key | 36-5019CT-ND | TP_SMT_LOOP-5019_3D | 18-0011-002 | 5019 | SMT | 1
TP19 | Test Point | Test Point, SMT, Miniature | Digi-Key | 36-5019CT-ND | TP_SMT_LOOP-5019_3D | 18-0011-002 | 5019 | SMT | 1
TP20 | Test Point | Test Point, SMT, Miniature | Digi-Key | 36-5019CT-ND | TP_SMT_LOOP-5019_3D | 18-0011-002 | 5019 | SMT | 1
TP21 | Test Point | Test Point, SMT, Miniature | Digi-Key | 36-5019CT-ND | TP_SMT_LOOP-5019_3D | 18-0011-002 | 5019 | SMT | 1
TP22 | Test Point | Test Point, SMT, Miniature | Digi-Key | 36-5019CT-ND | TP_SMT_LOOP-5019_3D | 18-0011-002 | 5019 | SMT | 1
TP23 | Test Point | Test Point, SMT, Miniature | Digi-Key | 36-5019CT-ND | TP_SMT_LOOP-5019_3D | 18-0011-002 | 5019 | SMT | 1
TP24 | Test Point | Test Point, SMT, Miniature | Digi-Key | 36-5019CT-ND | TP_SMT_LOOP-5019_3D | 18-0011-002 | 5019 | SMT | 1
TP25 | Test Point | Test Point, SMT, Miniature | Digi-Key | 36-5019CT-ND | TP_SMT_LOOP-5019_3D | 18-0011-002 | 5019 | SMT | 1
TP26 | Test Point | Test Point, SMT, Miniature | Digi-Key | 36-5019CT-ND | TP_SMT_LOOP-5019_3D | 18-0011-002 | 5019 | SMT | 1
TP27 | Test Point | Test Point, SMT, Miniature | Digi-Key | 36-5019CT-ND | TP_SMT_LOOP-5019_3D | 18-0011-002 | 5019 | SMT | 1
TP28 | Test Point | Test Point, SMT, Miniature | Digi-Key | 36-5019CT-ND | TP_SMT_LOOP-5019_3D | 18-0011-002 | 5019 | SMT | 1
TP29 | Test Point | Test Point, SMT, Miniature | Digi-Key | 36-5019CT-ND | TP_SMT_LOOP-5019_3D | 18-0011-002 | 5019 | SMT | 1
TP30 | Test Point | Test Point, SMT, Miniature | Digi-Key | 36-5019CT-ND | TP_SMT_LOOP-5019_3D | 18-0011-002 | 5019 | SMT | 1
TP31 | Test Point | Test Point, SMT, Miniature | Digi-Key | 36-5019CT-ND | TP_SMT_LOOP-5019_3D | 18-0011-002 | 5019 | SMT | 1
TP32 | Test Point | Test Point, SMT, Miniature | Digi-Key | 36-5019CT-ND | TP_SMT_LOOP-5019_3D | 18-0011-002 | 5019 | SMT | 1
TP33 | Test Point | Test Point, SMT, Miniature | Digi-Key | 36-5019CT-ND | TP_SMT_LOOP-5019_3D | 18-0011-002 | 5019 | SMT | 1
TP34 | Test Point | Test Point, SMT, Miniature | Digi-Key | 36-5019CT-ND | TP_SMT_LOOP-5019_3D | 18-0011-002 | 5019 | SMT | 1
TP35 | Test Point | Test Point, SMT, Miniature | Digi-Key | 36-5019CT-ND | TP_SMT_LOOP-5019_3D | 18-0011-002 | 5019 | SMT | 1
U1 | NCP1340B3 | Controller, PWM, NCP1340B3, SOIC-9 | Digi-Key | NCP1340B3D1R2GOSCT-ND | SOIC100P600X175-9M | 11-0021-001 |  | SOIC-9 | 1
U2 | TSM104WAID | Op-Amp With Reference, TSM104WAID, Quad, Low Offset, SOIC-16 | Digi-Key | 296-21202-1-ND | SOIC127P600X175-16M_IPC | 11-0006-006 |  | SOIC-16 | 1
U3 | TL431A | Shunt Regulator, TL431A, Adjustable, 2.495 V, 1%, SOT-23-3 | Digi-Key | 296-17328-1-ND | SOT95P230X124-3M_IPC | 11-0008-006 |  | SOT-23-3 | 1

Sheet: Transformer BOM
Transformer Bill Of Materials
Note: | For indeterminate or variable quantities, such as the amount of margin tape, use "A/R" (stands for "As Required") for the quantity
Item Number | Part Number | Description | Quantity | Note/Comment
1 | 17-0001-002 | Core Half, ETD29, N87 | 2 | Core
2 | 17-0002-002 | Bobbin, ETD29, Horizontal, 13 Pins | 1 | Bobbin
3 | 17-0002-003 | Clip, ETD29 | 2 | Bobbin Clip
4 | 18-0007-006 | Wire, Magnet, 24 AWG, 155 °C, Enameled, MW80-C | A/R | Primary Winding, 1st Layer
5 | 17-0009-002 | Tape, Insulating, Polyester, Type 56, 0.188 in | A/R | Margin Tape, Primary Winding
6 | 17-0009-013 | Tape, Insulating, Polyester, Type 56, 0.75 in | A/R | Insulating Tape, Primary-To-Secondary
