chinmay09/ECEN_5009_Project_Lab/Patil_Stress_Analysis_20181208/Patil_Stress_Analysis_20181202.xlsx

Sheet: Project Information
ECEN 5009 Power Electronics Project Lab
Prepared By: | Chinmay Patil
Project: | ECEN 5009 LED Driver/Stress Analysis Spreadsheet
Last Updated: | 2018-11-02

Sheet: Stress Analysis
ECEN5009 LED Driver Stress Analysis
Required Ratings Information By Component Type
For each component class, if a "Y" appears then that component stress (e.g. Voltage) must be entered in Ratings, Derated Limits, and Applied Component Stress
 |  |  | Component Ratings
 | Class Number | Component Type | Voltage (V) | Current (A) | Power (W) | Junction Temperature (°C) | Notes
 | 10 | Transistors | Y |  |  | Y | Voltage: Drain-To-Source Voltage
 | 13 | Diodes | Y | Y |  | Y
 | 15 | Resistors | Y |  | Y
 | 16 | Capacitors, Electrolytic | Y | Y |  |  | Current: RMS Ripple Current
 | 16 | Capacitors, Ceramic | Y
 | 16 | Capacitors, Film | Y | Y |  |  | Current: RMS Ripple Current
 |  |  | Component Ratings |  |  |  | Derated Limits |  |  |  | Applied Component Stress |  |  |  |  | Calculations
Reference Designator | Part Number | Description | Voltage (V) | Current (A) | Power (W) | Junction Temperature (°C) | Voltage (V) | Current (A) | Power (W) | Junction Temperature (°C) | Voltage (V) | Current (A) | Power (W) | Junction Temperature (°C) | Pass/ Fail
Q1 | 10-0016-001 | MOSFET, N-Channel, IPB90R340C3ATMA1, 900 V, 340 mOhm, D²PAK | 900 |  |  | 150 | 700 |  |  | 115 | 378 |  |  | 36.04 | Pass | - | Junction Temperature Calculations shown in Main Power Stage
D1 | DF06S2CT-ND | Diode, Bridge, Std Recovery, DF06S2, 600 V, 2 A, SDIP-4 | 600 | 2 |  | 150 | 450 | 2 |  | 115 | 374 | 0.309 |  | 64.98 | Pass | Current found through simulations
D2 | EGP30CCT-ND | Diode, Fast Recovery, EGP30C, 150 V, 3 A, DO-201AD | 150 | 3 |  | 150 | 112.5 | 3 |  | 115 | 71.98 | 3 |  | 88.71 | Pass | I_secondary RMS current flowing
D3 | RS1MFSCT-ND | Diode, Fast Recovery, RS1M, 1000 V, 1 A, SMA | 1000 | 1 |  | 150 | 750 | 1 |  | 115 | 302 | 0.00487 |  | 30.66 | Pass | Current found through simulations
D4 | RS1MFSCT-ND | Diode, Fast Recovery, RS1M, 1000 V, 1 A, SMA | 1000 | 1 |  | 150 | 750 | 1 |  | 115 | 374 | 0.309 |  | 32.73 | Pass | Current found through simulations
D5 | RS1MFSCT-ND | Diode, Fast Recovery, RS1M, 1000 V, 1 A, SMA | 1000 | 1 |  | 150 | 750 | 1 |  | 115 | 374 | 0.309 |  | 32.73 | Pass | Current found through simulations
D6 | ES3BFSCT-ND | Diode, Fast Recovery, ES3B, 100 V, 3 A, SMC | 100 | 3 |  | 150 | 75 | 3 |  | 115 | 73.33 | 0.01 |  | 33.56 | Pass | I_auxiliary RMS current flowing
D7 | RS1ACT-ND | Diode, Fast Recovery, RS1A, 50 V, 1 A, SMA | 50 | 1 |  | 150 | 37.5 | 1 |  | 115 | 0.016 | 0.8 |  | 40.92 | Pass | Max_Sinking Current of NCP1340
D8 | RS1BFSCT-ND | Diode, Fast Recovery, RS1B, 100 V, 1 A, SMA | 100 | 1 |  | 150 | 75 | 1 |  | 115 | 53.2 | 0.01 |  | 30.013 | Pass | I_auxiliary RMS current flowing
R1 | 62KW-2-ND | Resistor, TH, 62.0 K, 5%, 2 W, MO, Axial | 350 |  | 2 |  | 245 |  | 1 |  | 151.28 |  | 0.369 |  | Pass | Current found through simulations
R2 | 15-0004-129 | Resistor, SMT, 20.0 K, 5%, 1 W, 2512 | 200 |  | 2 |  | 140 |  | 1 |  | 97 |  | 0.388 |  | Pass | Current found through simulations
R3 | 91KW-2-ND | Resistor, TH, 91.0 K, 5%, 2 W, MO, Axial | 350 |  | 2 |  | 245 |  | 1 |  | 222.04 |  | 0.541 |  | Pass | Current found through simulations
R4 | 15-0004-129 | Resistor, SMT, 20.0 K, 5%, 1 W, 2512 | 200 |  | 2 |  | 140 |  | 1 |  | 97 |  | 0.388 |  | Pass | Current found through simulations
R5 | 15-0012-001 | Resistor, SMT, 100m, 1%, 1 W, 2512 | 200 |  | 1 |  | 140 |  | 0.5 |  | 0.12 |  | 0.144 |  | Pass | Power = Voltage*I_secondary_rms
R6 | 2.0KW-2-ND | Resistor, TH, 2.00 K, 5%, 2 W, MO, Axial | 350 |  | 2 |  | 245 |  | 1 |  | 40 |  | 0.8 |  | Pass | Power = Voltage*I_prim_rms
R7 | 15-0012-003 | Resistor, SMT, 470 m, 1%, 1 W, 2512 | 350 |  | 5 |  | 245 |  | 2.5 |  | 0.715 |  | 0.3861 |  | Pass | Power = Voltage*I_prim_rms
R8 | 15-0004-098 | Resistor, SMT, 1.00 K, 5%, 1 W, 2512 | 200 |  | 1 |  | 140 |  | 0.5 |  | 0.00162 |  | 2.62e-09 |  | Pass | NCP1340 Datasheet
R9 | 15-0002-001 | Resistor, SMT, 1.00, 1%, 125 mW, 0805 | 150 |  | 0.125 |  | 105 |  | 0.0625 |  | 0.016 |  | 0.016 |  | Pass | Power = Voltage*I_sinking_max
R10 |  | Resistor, SMT, 430 K, 5%, 1 W, 2512 | 200 |  | 1 |  | 140 |  | 0.5 |  | 0.6966 |  | 1.12e-06 |  | Pass | NCP1340 Datasheet
R11 | 15-0002-097 | Resistor, SMT, 10.0, 1%, 125 mW, 0805 | 150 |  | 0.125 |  | 105 |  | 0.0625 |  | 0.016 |  | 0.0016 |  | Pass | Power = Voltage*I_sourcing_max
R12 | 15-0003-385 | Resistor, SMT, 10.0 K, 1%, 250 mW, 1206 | 200 |  | 0.25 |  | 140 |  | 0.125 |  | 15.285 |  | 0.0232 |  | Pass | Power = Voltage*I_sourcing_max
R13 | 15-0004-105 | Resistor, SMT, 2.00 K, 5%, 1 W, 2512 | 200 |  | 1 |  | 140 |  | 0.5 |  | 30.7 |  | 0.4712 |  | Pass | NCP1340 Datasheet
R14 | 15-0003-432 | Resistor, SMT, 30.9 K, 1%, 250 mW, 1206 | 200 |  | 0.25 |  | 140 |  | 0.125 |  | 3.2 |  | 0.0003313 |  | Pass | Power = FB_Voltage*I_FB_max
R15 | 15-0003-385 | Resistor, SMT, 10.0 K, 1%, 250 mW, 1206 | 200 |  | 0.25 |  | 140 |  | 0.125 |  | 2.5 |  | 0.000625 |  | Pass | Current found through simulations
R16 | 15-0003-443 | Resistor, SMT, 40.2 K, 1%, 250 mW, 1206 | 200 |  | 0.25 |  | 140 |  | 0.125 |  | 4.783 |  | 0.000569 |  | Pass | I_R16 = I_rcs/2
R17 | 15-0003-306 | Resistor, SMT, 1.50 K, 1%, 250 mW, 1206 | 200 |  | 0.25 |  | 140 |  | 0.125 |  | 0.1785 |  | 2.12e-05 |  | Pass | I_R17 = I_rcs/2
R19 | 15-0003-385 | Resistor, SMT, 10.0 K, 1%, 250 mW, 1206 | 200 |  | 0.25 |  | 140 |  | 0.125 |  | 30 |  | 0.09 |  | Pass | Current found through simulations
R20 | 15-0003-289 | Resistor, SMT, 1.00 K, 1%, 250 mW, 1206 | 200 |  | 0.25 |  | 140 |  | 0.125 |  | 0.003 |  | 9e-09 |  | Pass | I_R20 = I_rcs/2
R21 | 15-0003-289 | Resistor, SMT, 1.00 K, 1%, 125 mW, 0805 | 200 |  | 0.25 |  | 140 |  | 0.125 |  | 1.4 |  | 0.001358 |  | Pass | Power = V_diode_opto*Ie_min
R22 | 15-0003-193 | Resistor, SMT, 100, 1%, 250 mW, 1206 | 200 |  | 0.25 |  | 140 |  | 0.125 |  | 0.01 |  | 3.32e-07 |  | Pass | Current found through simulations
R23 | 15-0003-385 | Resistor, SMT, 10.0 K, 1%, 250 mW, 1206 | 200 |  | 0.25 |  | 140 |  | 0.125 |  | 27.5 |  | 0.0756 |  | Pass | Current found through simulations
R24 | 15-0003-289 | Resistor, SMT, 1.00 K, 1%, 250 mW, 1206 | 200 |  | 0.25 |  | 140 |  | 0.125 |  | 0.003 |  | 9e-09 |  | Pass | I_R24 = I_rcs/2
R25 | 15-0007-397 | Resistor, TH, 13.3 K, 1%, 250 mW, MF, Axial | 200 |  | 0.25 |  | 140 |  | 0.125 |  | 17.5 |  | 0.0322 |  | Pass | Power = Voltage*Ibias
R26 | 15-0003-385 | Resistor, SMT, 10.0 K, 1%, 250 mW, 1206 | 200 |  | 0.25 |  | 140 |  | 0.125 |  | 5 |  | 0.0025 |  | Pass | Current found through simulations
R27 | 15-0003-350 | Resistor, SMT, 4.32 K, 1%, 250 mW, 1206 | 200 |  | 0.25 |  | 140 |  | 0.125 |  | 6.65 |  | 0.00665 |  | Pass | Power = Voltage*Ik_min
R28 | 15-0003-443 | Resistor, SMT, 40.2 K, 1%, 250 mW, 1206 | 200 |  | 0.25 |  | 140 |  | 0.125 |  | 0.112 |  | 3.14e-07 |  | Pass | I_R28 = I_rcs/2
R29 | 15-0003-306 | Resistor, SMT, 1.50 K, 1%, 250 mW, 1206 | 200 |  | 0.25 |  | 140 |  | 0.125 |  | 0.004207 |  | 1.18e-08 |  | Pass | I_R29 = I_rcs/2
R30 | 15-0003-385 | Resistor, SMT, 10.0 K, 1%, 250 mW, 1206 | 200 |  | 0.25 |  | 140 |  | 0.125 |  | 5 |  | 0.0025 |  | Pass | Current found through simulations
R31 | 15-0007-351 | Resistor, TH, 4.42 K, 1%, 250 mW, MF, Axial | 200 |  | 0.25 |  | 140 |  | 0.125 |  | 2.5 |  | 0.0021 |  | Pass | Power = Vprog*Iprog
R32 | 15-0003-327 | Resistor, SMT, 2.49 K, 1%, 250 mW, 1206 | 200 |  | 1 |  | 140 |  | 0.5 |  | 2.5 |  | 0.0025 |  | Pass | Power = Vadj*Ibias
R33 | 15-0004-114 | Resistor, SMT, 4.70 K, 5%, 1 W, 2512 | 200 |  | 1 |  | 140 |  | 0.5 |  | 27.5 |  | 0.1592 |  | Pass | Power = Max_Voltage*Ik_corresponding_to_voltage
R34 | 15-0004-122 | Resistor, SMT, 10.0 K, 5%, 1 W, 2512 | 200 |  | 1 |  | 140 |  | 0.5 |  | 71.98 |  |  |  | Pass | -
R35 | 15-0003-510 | Resistor, SMT, 200 K, 1%, 250 mW, 1206 | 200 |  | 0.25 |  | 140 |  | 0.125 |  | 4.15 |  | 4.565e-05 |  | Pass | Power = Fmax_Voltage*I_Fmax_max
R41 | 15-0004-105 | Resistor, SMT, 2.00 K, 5%, 1 W, 2512 | 200 |  | 1 |  | 140 |  | 0.5 |  | 9.7 |  | 0.047 |  | Pass | -
R42 | 15-0004-129 | Resistor, SMT, 20.0 K, 5%, 1 W, 2512 | 200 |  | 1 |  | 140 |  | 0.5 |  | 97 |  | 0.388 |  | Pass | -
R45 | 15-0002-193 | Resistor, SMT, 100, 1%, 125 mW, 0805 | 150 |  | 0.125 |  | 105 |  | 0.0625 |  | 0.2 |  | 2e-05 |  | Pass | 100 microamp current considered
C1 | PCF1616-ND | Capacitor, Film, 1 µF, ±5%, 450 V, Metallized Polypropylene, Radial, Lead | 450 |  |  |  |  |  |  |  |  |  |  |  | Pass | Current found through simulations
C2 | 493-17561-ND | Capacitor, Al. El., 150 µF, ±20%, 450 V, Radial, Snap | 450 | 1.38 |  |  | 405 | 0.966 |  |  | 374 | 0.264 |  |  | Pass | Current found through simulations
C3 | 720-1057-1-ND | Capacitor, Ceramic, 4.7 nF, ±10%, 1000 V, X7R, 1210 | 1000 |  |  |  | 700 |  |  |  | 302 |  |  |  | Pass | -
C4 | 493-1602-ND | Capacitor, Al. El., 3.9 mF, ±20%, 35 V, Radial, Lead | 35 | 4.28 |  |  | 31.5 | 2.996 |  |  | 29 | 2.7521 |  |  | Pass | Current found through simulations
C5 | 16-0001-066 | Capacitor, Ceramic, 100 nF, ±10%, 50 V, X7R, 0805 | 50 |  |  |  | 35 |  |  |  | 20 |  |  |  | Pass | -
C6 | PCE4025CT-ND | Capacitor, Al. El., 22 µF, ±20%, 35 V, SMT | 35 | 0.14 |  |  | 31.5 | 0.098 |  |  | 30 | 0.00905 |  |  | Pass | Main Power stage calculations
C7 | 16-0001-038 | Capacitor, Ceramic, 470 pF, ±5%, 50 V, NP0, 0805 | 50 |  |  |  | 35 |  |  |  | 3.2 |  |  |  | Pass | -
C8 | 16-0002-059 | Capacitor, Ceramic, 100 nF, ±10%, 50 V, X7R, 1206 | 50 |  |  |  | 35 |  |  |  | 3.772 |  |  |  | Pass | -
C9 | 16-0001-054 | Capacitor, Ceramic, 10 nF, ±10%, 50 V, X7R, 0805 | 50 |  |  |  | 45 |  |  |  | 1.38 |  |  |  | Pass | Current found through simulations
C10 | 720-1045-1-ND | Capacitor, Ceramic, 1 nF, ±10%, 1000 V, X7R, 1210 | 1000 |  |  |  | 700 |  |  |  | 71.98 |  |  |  | Pass | -
C11 | 16-0002-059 | Capacitor, Ceramic, 100 nF, ±10%, 50 V, X7R, 1206 | 50 |  |  |  | 35 |  |  |  | 20 |  |  |  | Pass | -
C12 | 16-0001-042 | Capacitor, Ceramic, 1 nF, ±10%, 50 V, X7R, 0805 | 50 |  |  |  | 35 |  |  |  | 0.8 |  |  |  | Pass | -
