chinmay09/ECEN_5009_Project_Lab/Patil_Test_Report_20181205/Patil_Test_Report_2018122.xlsx

Sheet: Project Information
ECEN 5009 Power Electronics Project Lab: LED Driver Test Report
Prepared By: | Chinmay Patil
Project: | Led Driver
Last Updated: | 2018-11-11
Update: | Initial creation
Description: | Testing Data Recorded

Sheet: Corner Operation
Corner Case Operation
 |  |  |  |  |  |  | Measured Test Data
Case Definition |  |  |  | Test Conditions |  |  | Input Voltage | Input Power | Output Voltage | Shunt Voltage, DC | Shunt Voltage, AC | Calculated Results
Test Case Number | Input Voltage | AC Frequency | Dimming Voltage | Input Voltage | AC Frequency | Dimming Voltage | Vac RMS | W | Vdc | mVdc | mVac | Output Current | Output Power | Efficiency | LED Ripple Current | Percent Current Ripple
 | Vac RMS | Hz | Vdc | Vac RMS | Hz | Vdc | VVV.V | PP.P | VV.VV | MM.M | MM.MM | mAdc | W | % | mAac | %
1 | Min | Min | Min | 85 | 45 | 0 | 85.0 | 0.2 | 10.08 | 0.0 | 0.42 | 0.0 | 0.0 | 0.0% | 8.40 | #DIV/0!
2 | Min | Min | Mid | 85 | 45 | 5 | 85.0 | 14.6 | 18.39 | 31.1 | 1.15 | 621.4 | 11.4 | 78.3% | 23.00 | 0.2%
3 | Min | Min | Max | 85 | 45 | 10 | 85.0 | 32.0 | 20.18 | 62.3 | 1.92 | 1246.0 | 25.1 | 78.6% | 38.40 | 0.2%
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
