chinmay09/ECEN_5009_Project_Lab/Patil_PCBfiles_20181208/Patil_PCB_20181208_AssemblyDrawing.pdf

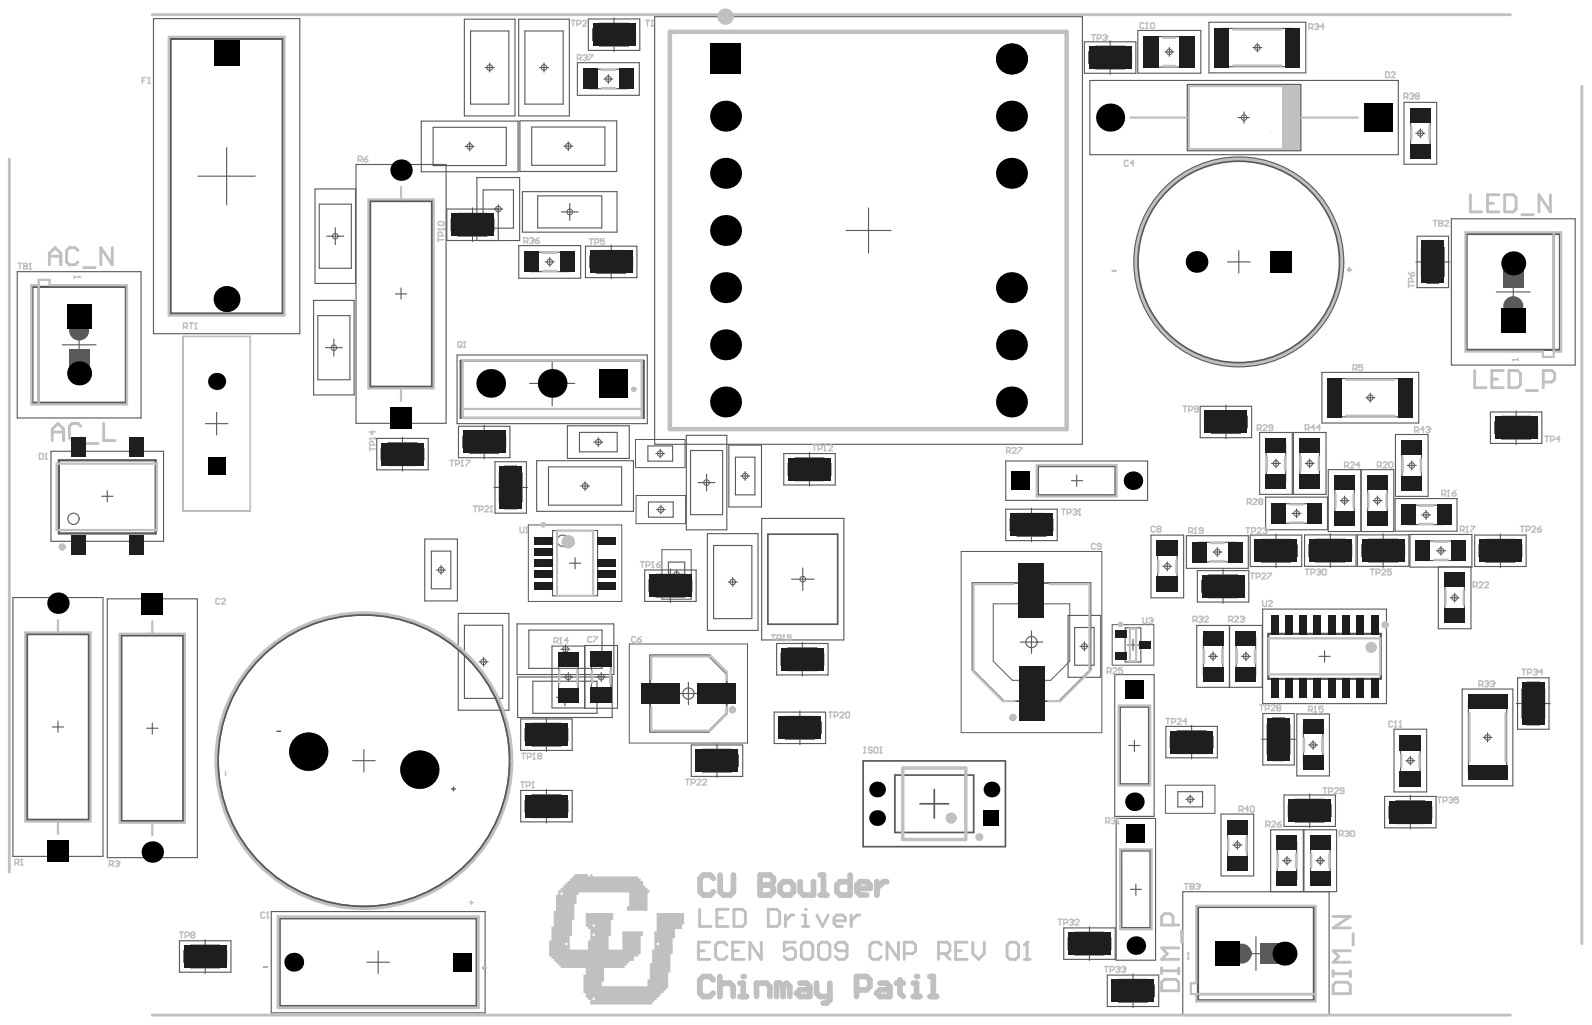
[picture p8: page 1]

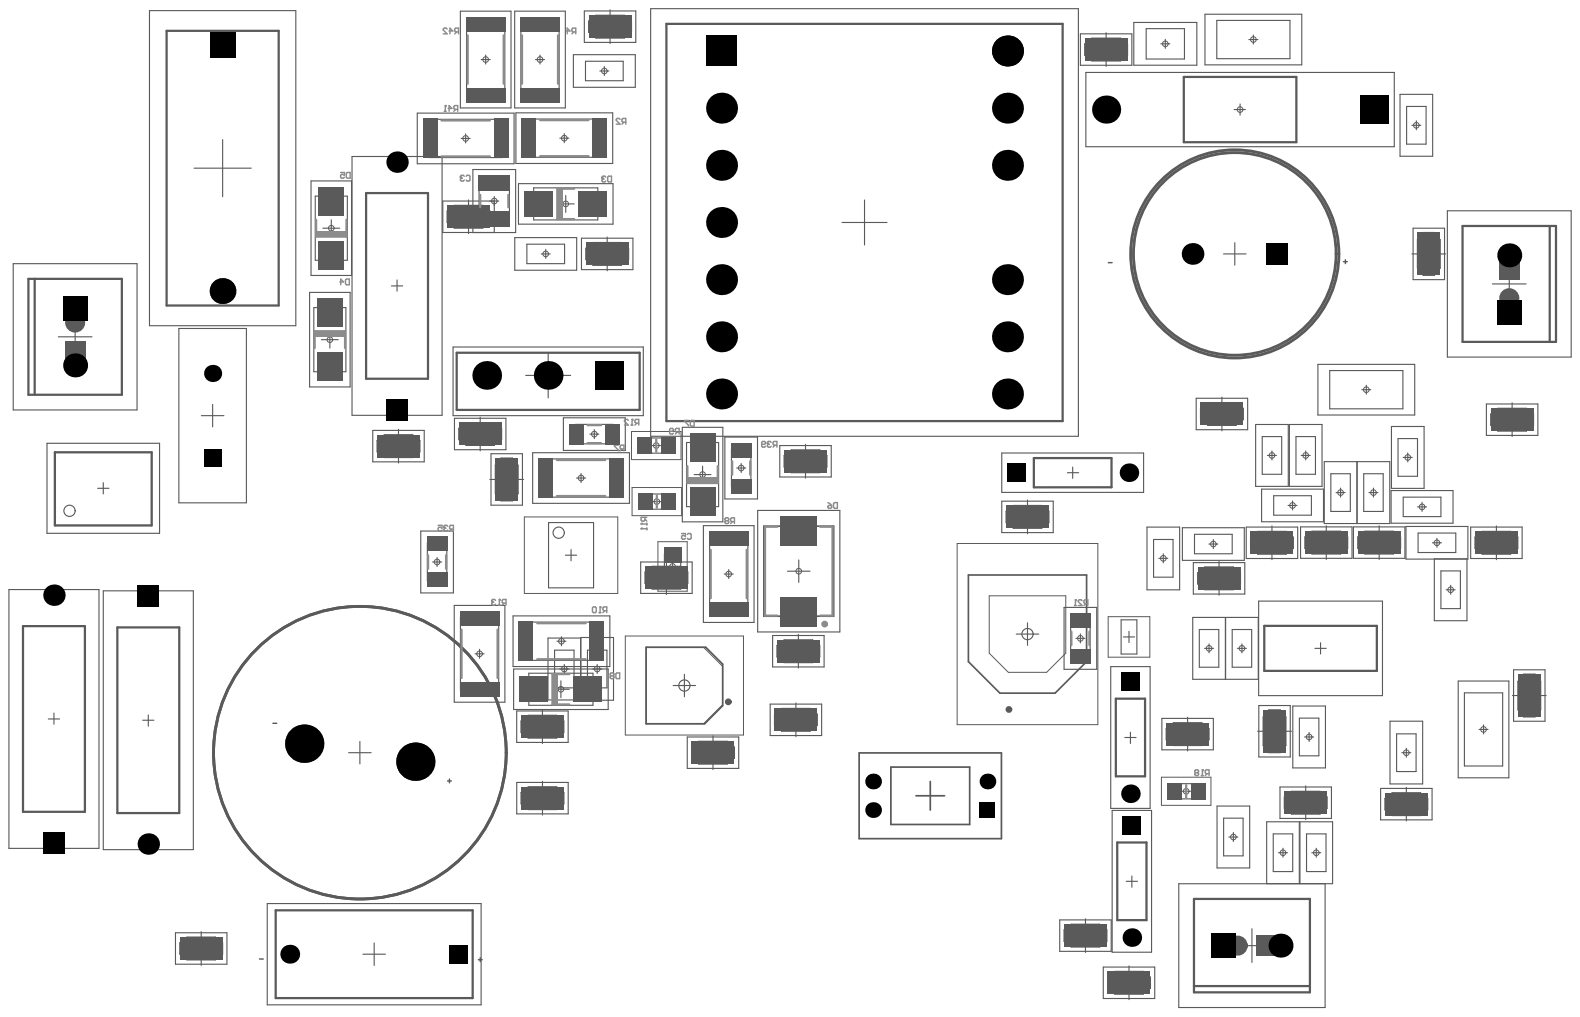
[picture p9: page 2]
