chinmay09/ECEN_5009_Project_Lab/Patil_PCBfiles_20181208/Patil_PCB_20181208_TopLayer.pdf

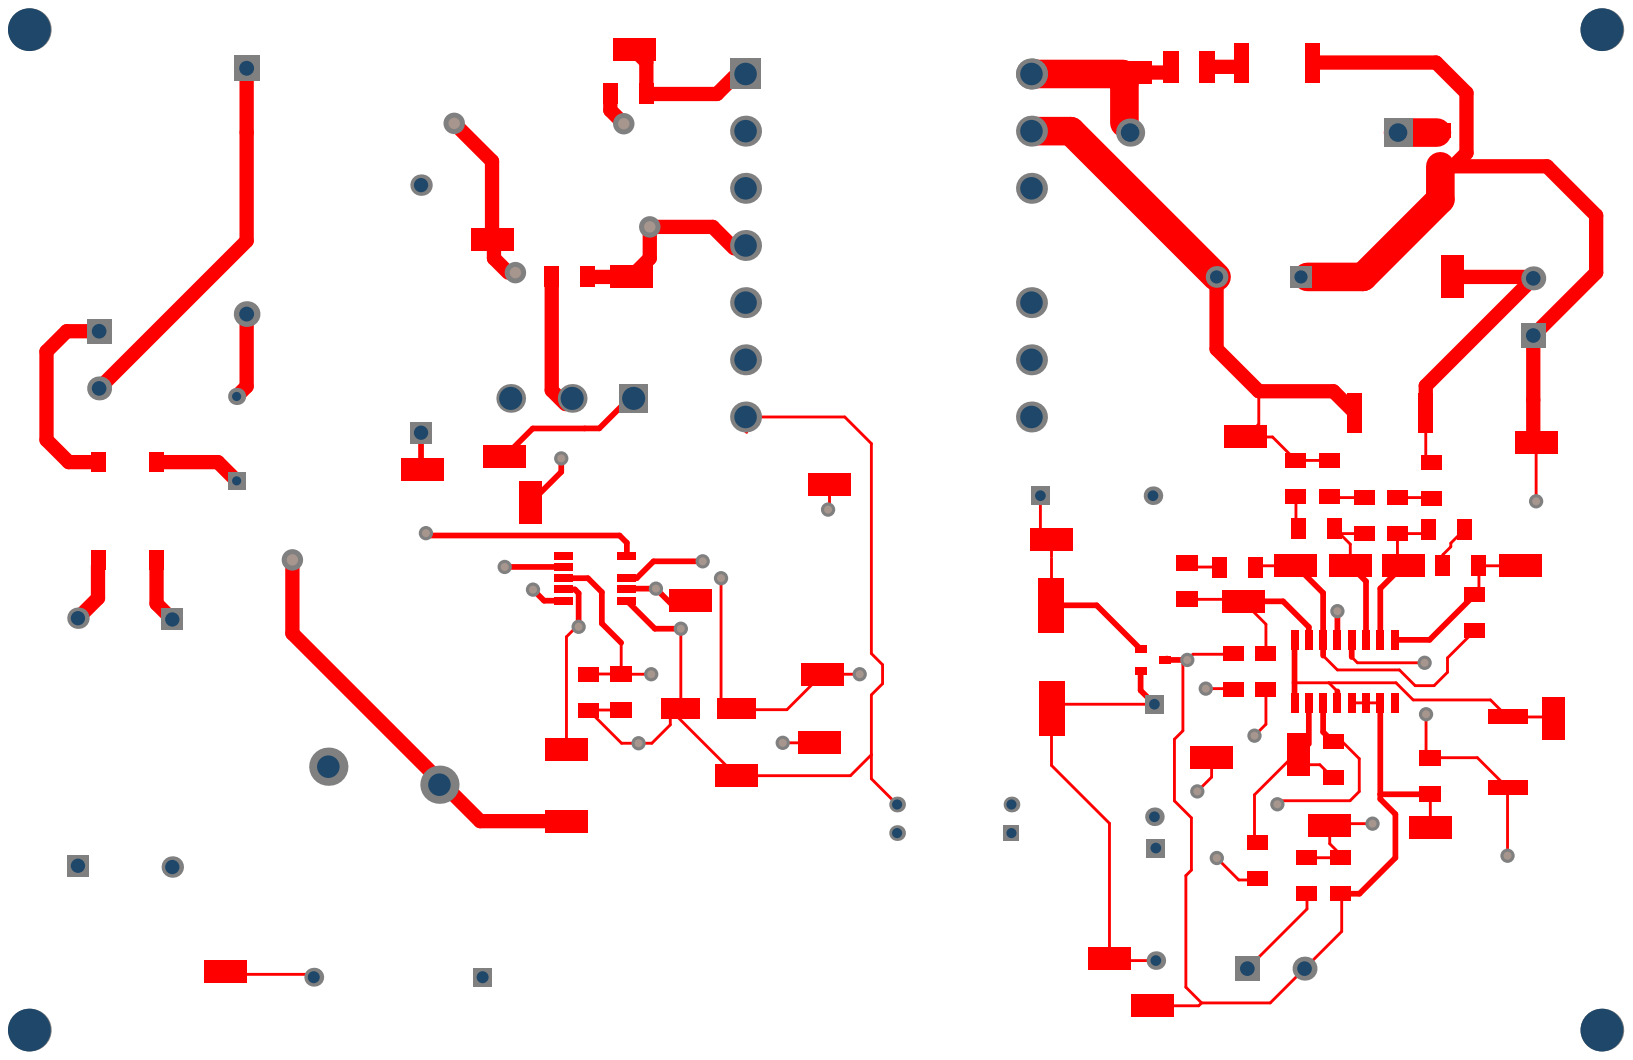
[picture p12: page 1]
