chinmay09/ECEN_5009_Project_Lab/(list of files, drawings)

Other design files:
Patil_PCBfiles_20181208/Patil_PCB_20181208.PcbDoc
Patil_PCBfiles_20181208/Patil_Project_20181208.PrjPcb
Patil_PCBfiles_20181208/Patil_Sheet_1_20181208.SchDoc
Patil_PCBfiles_20181208/Patil_Sheet_2_20181208.SchDoc
